SainsburyWellcomeCentre/aeon_feeder_fix/(list of files, cad)

Other CAD files:
mCAD/Beam_Break_-_Foraging_Feeder_Fix.iam
mCAD/Beam_Break_-_Foraging_Feeder_Fix_BOARD.ipt
mCAD/ConvertedComponents/CAP_CHIP_0603_CMP-611-0027-24.ipt
mCAD/ConvertedComponents/CAP_CHIP_0603_CMP-611-0035-10.ipt
mCAD/ConvertedComponents/FM_2.54_1X20P_CMP-380-0017-2.ipt
mCAD/ConvertedComponents/MOLEX_1.25_R_4P_CMP-370-0017-11.ipt
mCAD/ConvertedComponents/RES_CHIP_0603_CMP-633-0000-28.ipt
mCAD/ConvertedComponents/RES_CHIP_0603_CMP-633-0024-26.ipt
mCAD/ConvertedComponents/RES_CHIP_0603_CMP-633-0066-20.ipt
mCAD/ConvertedComponents/RES_CHIP_0603_CMP-633-0078-13.ipt
mCAD/ConvertedComponents/SOT23_CMP-810-0003-2.ipt
mCAD/ConvertedComponents/VSSOP8_3X3_0.65E_CMP-941-0002-4.ipt
