SainsburyWellcomeCentre/aeon_feeder_fix/eCAD/Documentation/Beam Break - Foraging Feeder Fix.PDF

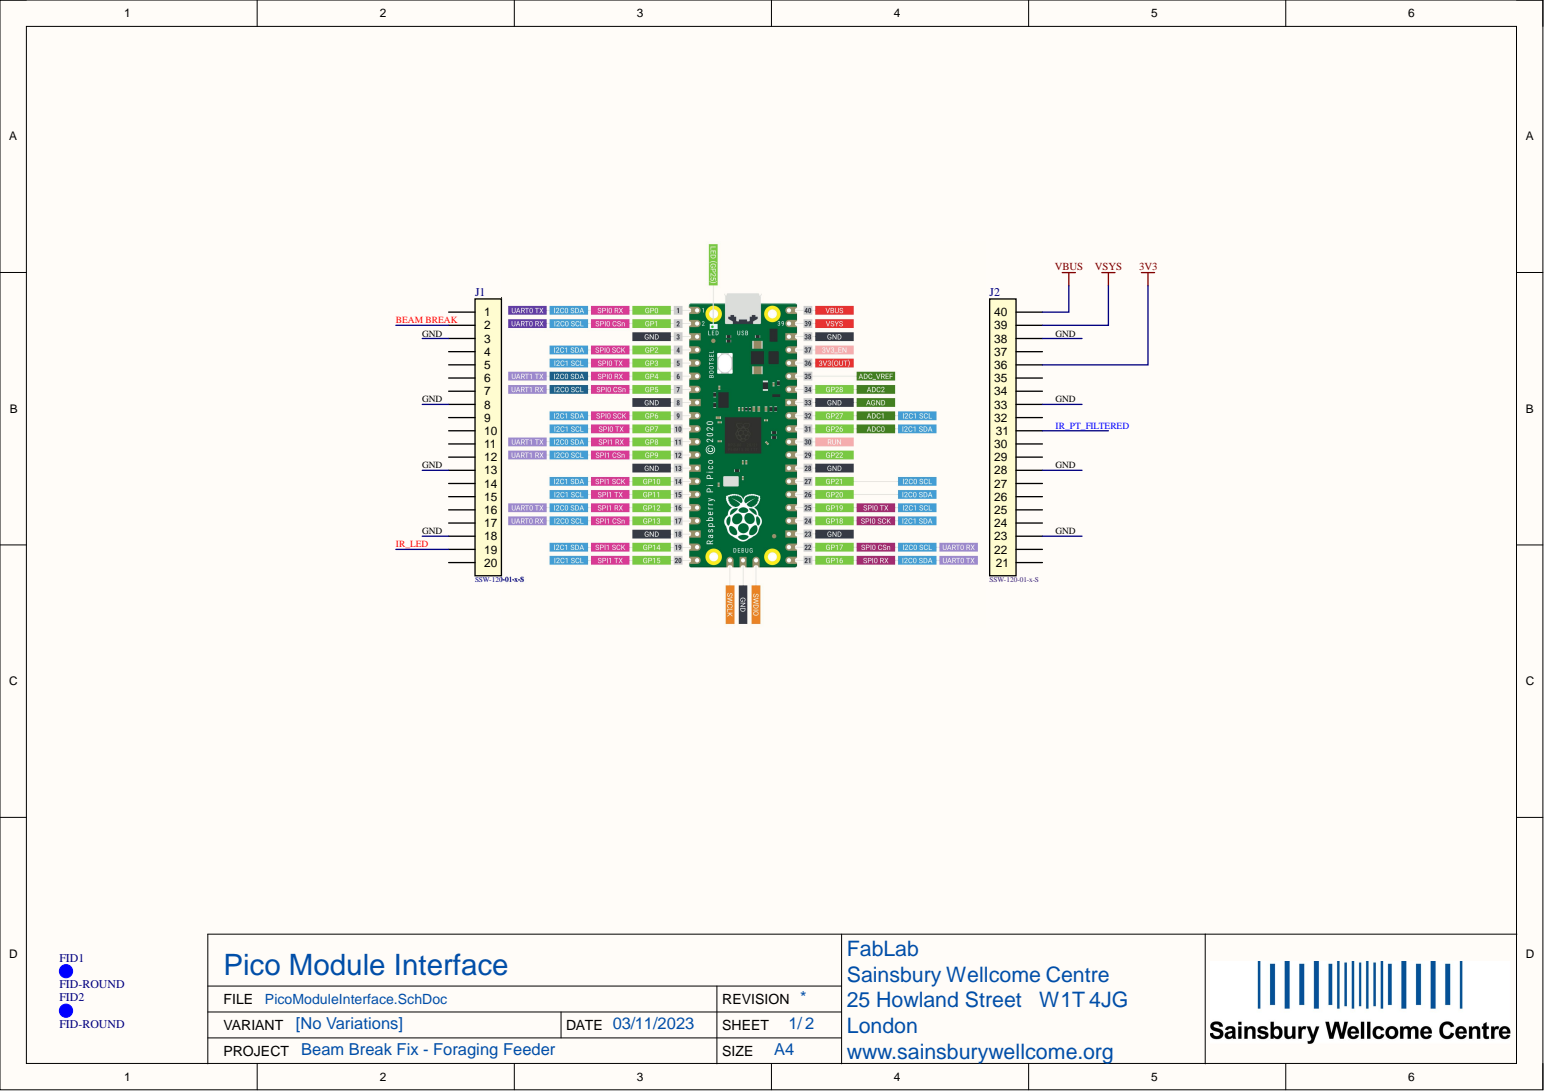
[picture p1: page 1]

FILE PicoModuleInterface.SchDoc | * REVISION
VARIANT [No Variations] | DATE | SHEET 1 / 2

PROJECT Beam Break Fix - Foraging Feeder

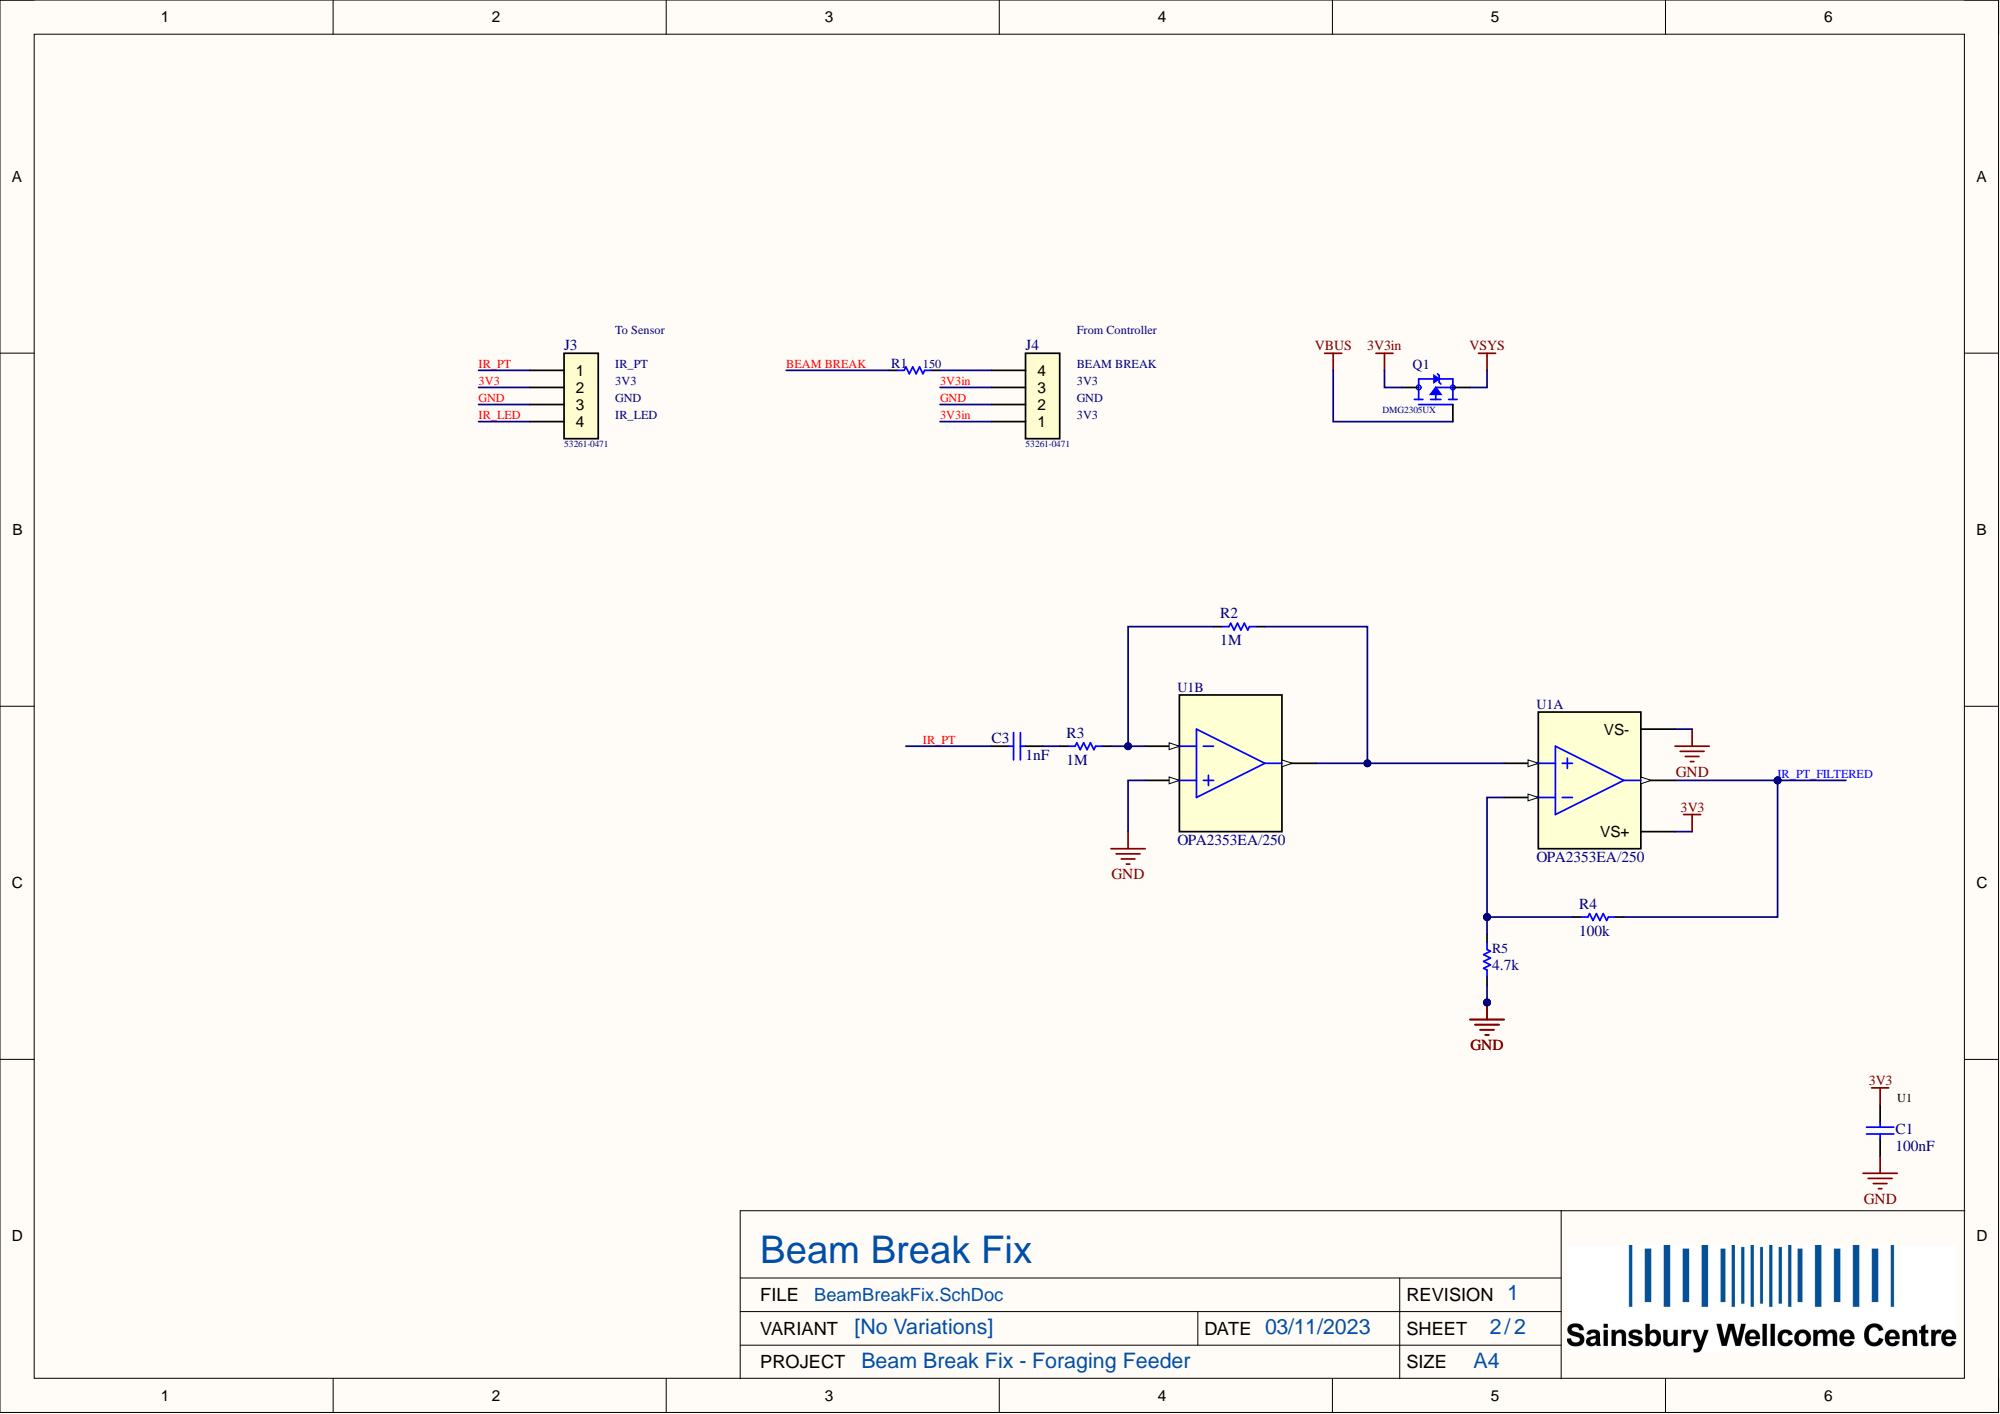
[picture p2: page 2]

FILE BeamBreakFix.SchDoc | 1 REVISION
VARIANT [No Variations] | | SHEET 2 2 /

PROJECT Beam Break Fix - Foraging Feeder

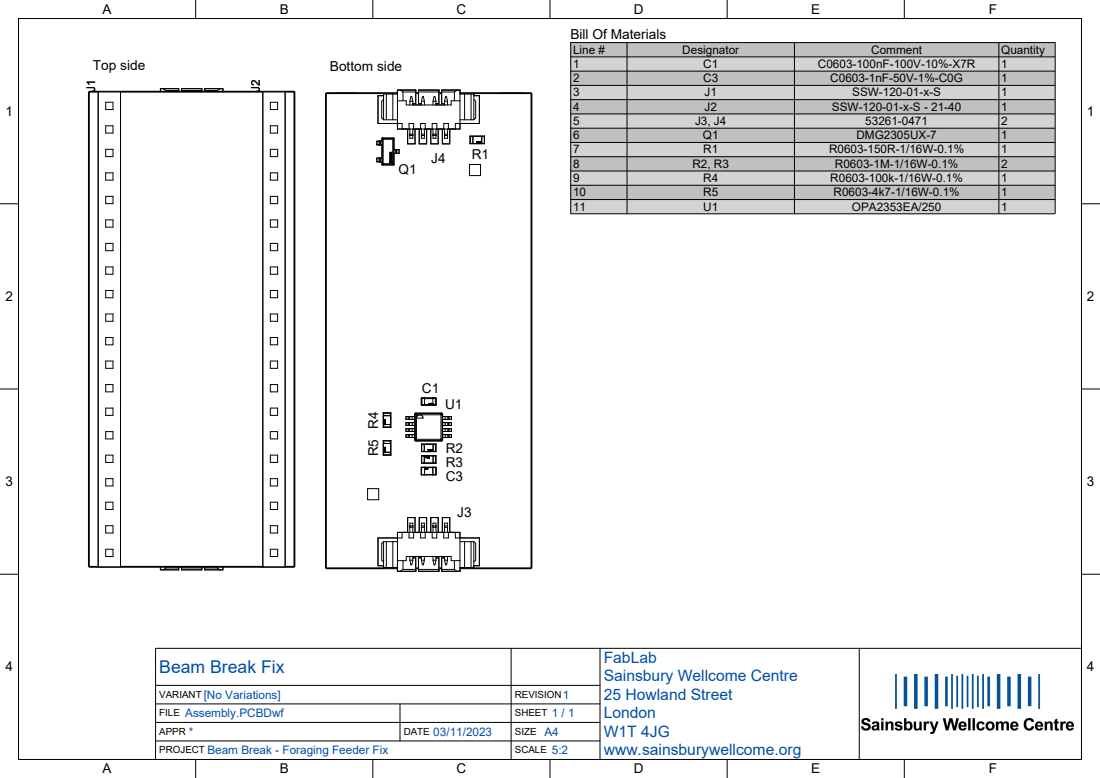
[picture p3: page 3]

Beam Break - Foraging Feeder Fix

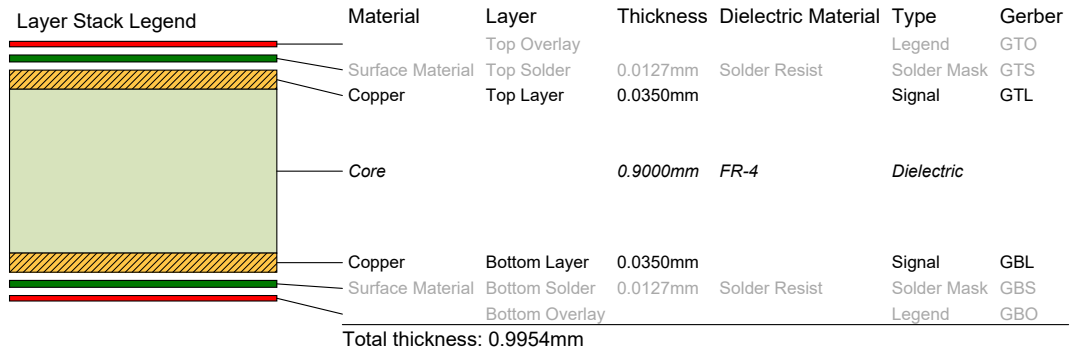
[picture p4: page 4]

[No Variations] VARIANT | 1 REVISION
FILE Fabrication.PCBDwf | | SHEET 1 / 2

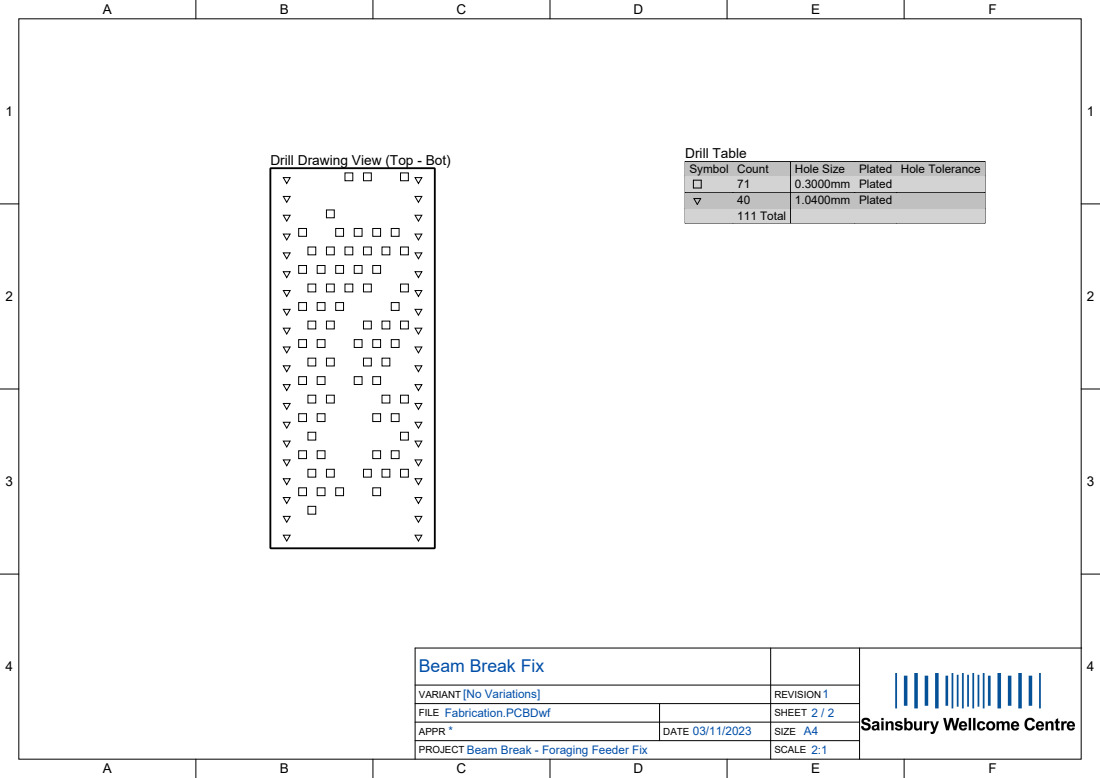
[picture p5: page 5]

Drill Drawing View (Top - Bot)

Symbol | Count | Hole Size | Plated | Hole Tolerance

71 | 0.3000mm | Plated
40 | 1.0400mm | Plated
111 Total

[No Variations] VARIANT | 1 REVISION
FILE Fabrication.PCBDwf | | SHEET 2 / 2
