SainsburyWellcomeCentre/aeon_feeder_fix/eCAD/Fabrication/Fabrication.PDF

[No Variations] VARIANT | 1 REVISION
FILE Fabrication.PCBDwf | | SHEET 1 / 2
APPR * | DATE 03/11/2023 | SIZE A4

Beam Break - Foraging Feeder Fix


Drill Drawing View (Top - Bot)

Symbol | Count | Hole Size | Plated | Hole Tolerance

71 | 0.3000mm | Plated
40 | 1.0400mm | Plated
111 Total

[No Variations] VARIANT | 1 REVISION
FILE Fabrication.PCBDwf | | SHEET 2 / 2
APPR * | DATE 03/11/2023 | SIZE A4

Beam Break - Foraging Feeder Fix
