SainsburyWellcomeCentre/aeon_feeder_fix/(list of files, drawings)

Other design files:
eCAD/SRC/Beam Break - Foraging Feeder Fix.PrjPcb
eCAD/SRC/BeamBreakFix.PcbDoc
eCAD/SRC/BeamBreakFix.SchDoc
eCAD/SRC/PicoModuleInterface.SchDoc
pcb-viewer.json
