SainsburyWellcomeCentre/aeon_feeder_fix/eCAD/Beam Break - Foraging Feeder Fix.kicad_pcb

## KiCad design eCAD/Beam Break - Foraging Feeder Fix.kicad_pcb (2026-07-10)

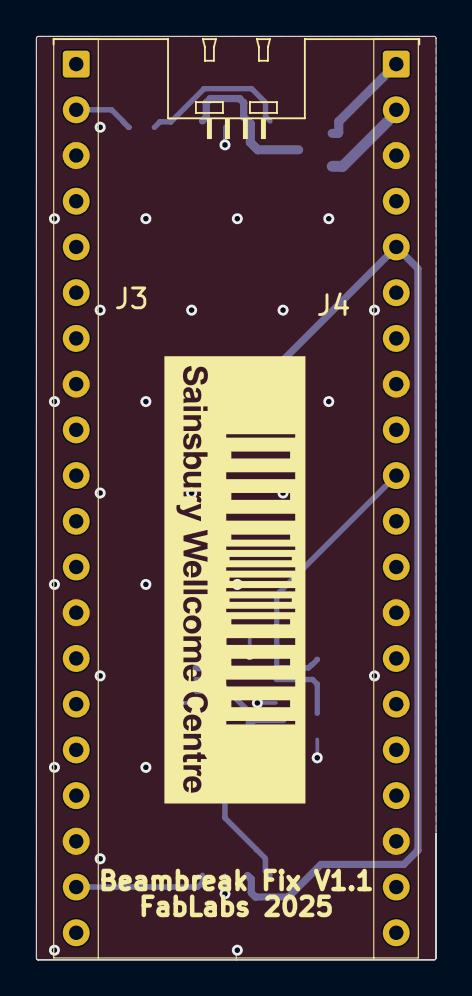
[picture p6: board Beam Break - Foraging Feeder Fix.kicad_pcb from above]

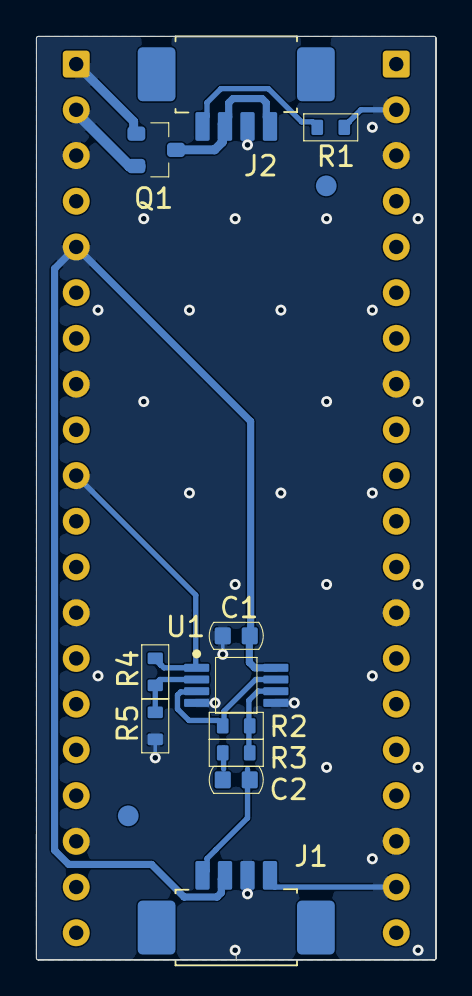
[picture p7: board Beam Break - Foraging Feeder Fix.kicad_pcb from below]

Board: 2 copper layers, 22.2 x 51.3 mm, 15 parts (13 on the bottom side), 14 nets.

Parts:
C1: C0603-100nF-50V; CAP_CHIP_0603
C2: C0603-1nF-50V; CAP_CHIP_0603
FID1, FID2: FID-ROUND; Fid_Round
J1, J2: Molex-1.25-R-4P; MOLEX_1.25_R_4P
J3: PICO-L; FM_2.54_1X20P
J4: PICO-R; FM_2.54_1X20P
Q1: AO3401A; SOT23
R1: R0603-150R; RES_CHIP_0603
R2, R3: R0603-1M; RES_CHIP_0603
R4: R0603-100K; RES_CHIP_0603
R5: R0603-4K7; RES_CHIP_0603
U1: AD8606; VSSOP8_3X3_0.65E

Connections:
3V3: C1.2, J1.2, J4.5, U1.8
3V3in: J2.1, J2.3, Q1.3
BEAM BREAK: J3.2, R1.1
GND: C1.1, J1.3, J2.2, J3.3, J3.8, J3.13, J3.18, J4.3, J4.8, J4.13, J4.18, R5.1, U1.4, U1.5
IR_LED: J1.4, J3.19
IR_PT: C2.1, J1.1
IR_PT_FILTERED: J4.10, R4.2, U1.1
NetC2_2: C2.2, R3.1
NetJ2_4: J2.4, R1.2
NetR2_1: R2.1, R3.2, U1.6
NetR2_2: R2.2, U1.3, U1.7
NetR4_1: R4.1, R5.2, U1.2
VBUS: J4.1, Q1.1
VSYS: J4.2, Q1.2
