SainsburyWellcomeCentre/aeon_feeder_fix/(threads)

Thread 4 (2025-02-18):

Feature requirements for new feeder

NeuroThom, 2025-02-18:
The new feeder is in the middle of the development and testing cycle. During this phase, we must test that some requirements are met.

- Round trip time between pellet delivery command and beam break should be ~100ms, with variance less than 50ms (or as low as possible)
    - On feeder initialisation / reset as well as general delivery

- Must know if beam break gets blocked.
     - It is neccessary to know if the beam break gets blocked, as we have seen many times the beam break getting stuck in a high state, presumably
       after dust accumulation.
     - Check every second, conditioned on the wheel not moving
     - In maintenance mode, the beam break should be switched on so can get constant readout for troubleshooting

- "Retry" pellets ideally will be removed from Bonsai.
     -  Instead, 'retry' function is done in hardware: the feeder continues rotating the disk until a pellet delivery is detected
     -  Can have a timer that detects when a delivery has not occurred in reasonable time (dependent on recorded latency and variance)
     -  Send an alert if delivery not possible
